codemicro/macropad/.github/README.md

# Macropad

A project to create a custom macropad based on the Raspberry Pi Pico, including custom hardware and software design.

## Links

* Raspberry Pi Pico Eagle CAD library - [codemicro/pico-eagle](https://github.com/codemicro/pico-eagle)
* Cherry MX keyswitche Eagle CAD library - [c0z3n/cherrymx-eagle](https://github.com/c0z3n/cherrymx-eagle)

## rev0

| **Board scan** | **Assembled** | **Schematic** |
| --- | --- | --- |
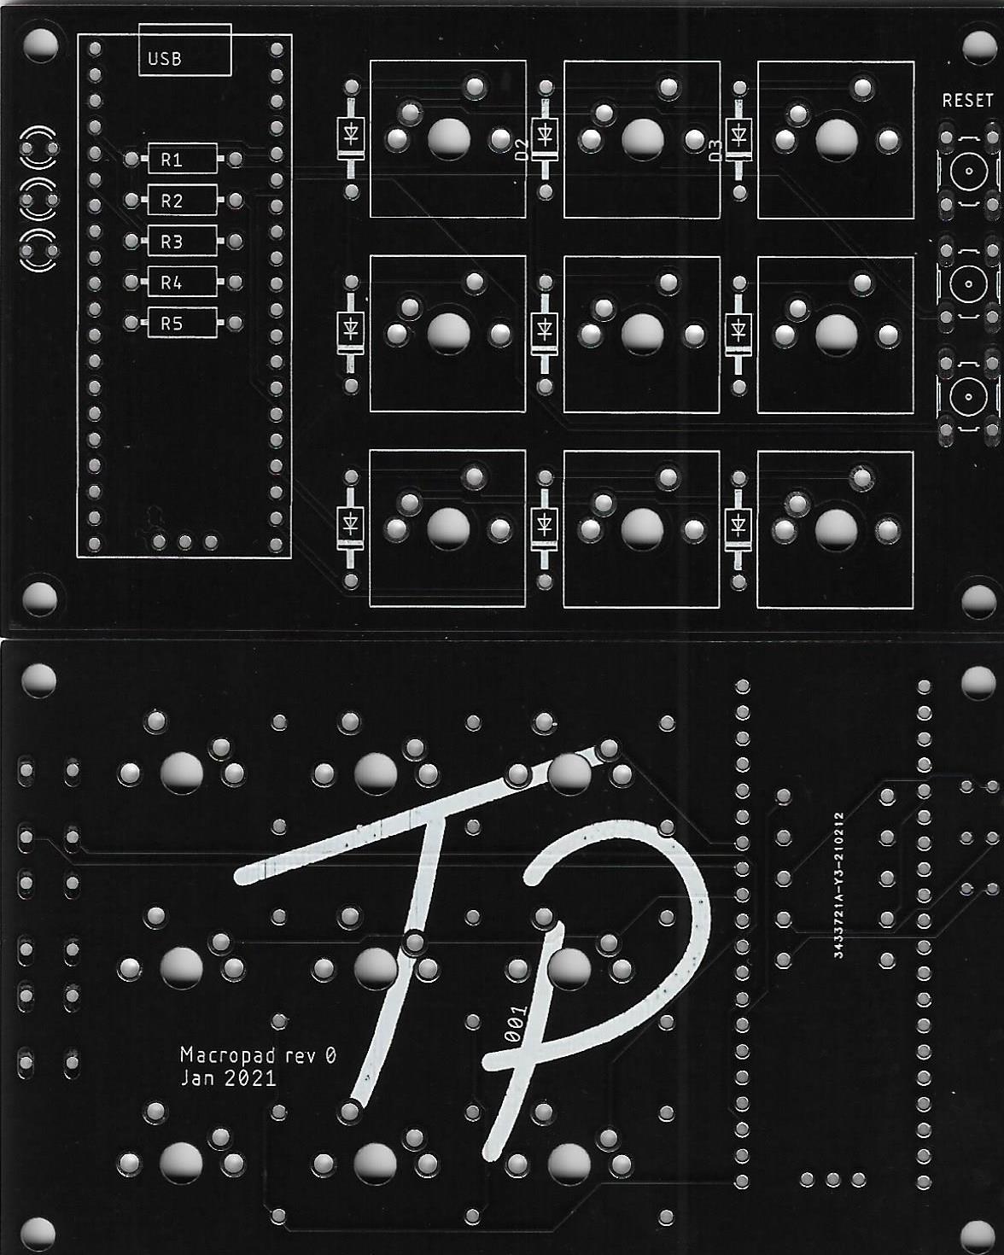
[picture p1: .github/images/rev0scan.jpg]
rev0 board scan
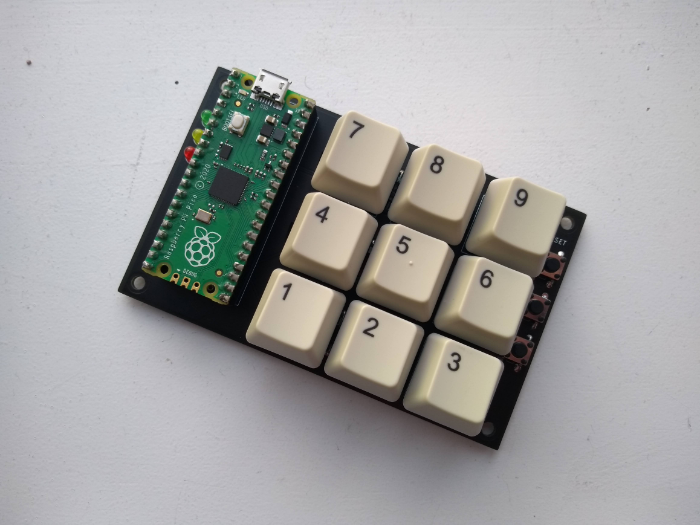
[picture p2: .github/images/rev0.png]
rev0 assembled
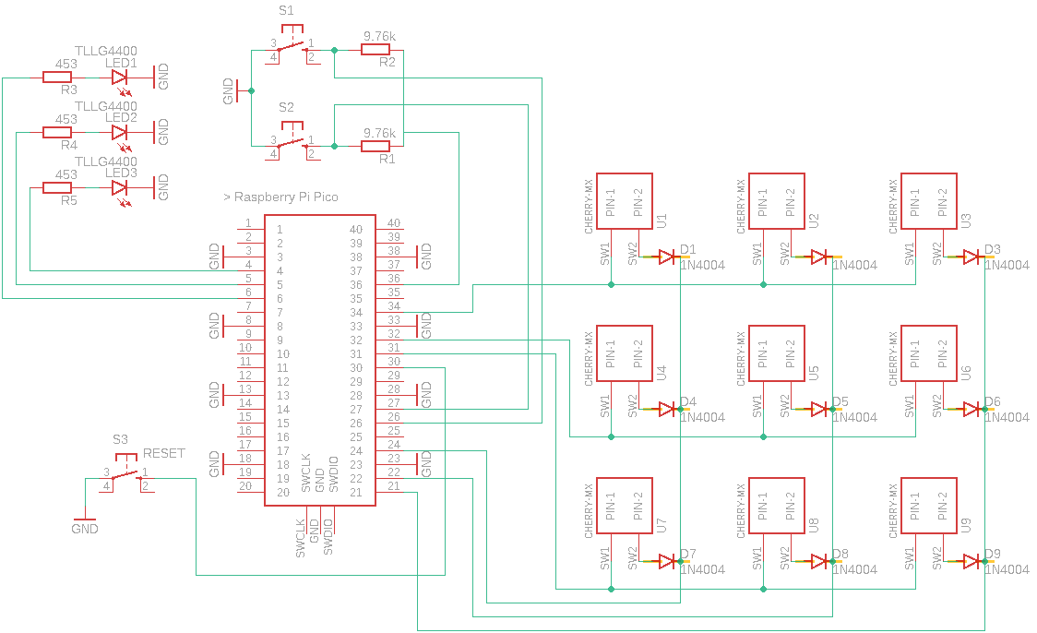
[picture p3: .github/images/rev0schem.png]
rev0 schematic
|  |  |  |

Functionally perfect, ideal LED position would be below the Pi Pico and not alongside it, however.

### Improvements

* Option for a small OLED I2C OLED display (like [this 0.96" one](https://www.amazon.co.uk/MakerHawk-Display-Module-128X64-Arduino/dp/B0777HHQDT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))
* Hotswap keyswitch sockets
* Multiple PCB layers, so the Pico or other microcontroller can be sandwiched inbetween
* Perhaps a different microcontroller, like the Pro Micro?
  * The Pico is more affordable than a genuine Pro Micro but [this thing](https://www.sparkfun.com/products/15795) does look super cool
* Pico SMD support using castellations instead of header pins
  * Maybe options for both on the same board?
* More/RGB LEDs
* Silkscreen had leftover component labels that I *thought* I'd properly removed (D2, D3)
