codemicro/macropad/design/rev0/README.txt

The following options were used when ordering these PCBs from JLCPCB. Take special note of "remove order number" - the text "JLCJLCJLCJLC" is present on the underside of the board to facilitate this.

Layers: 2
Dimension: 100*62mm
Delivery Fomat: Single PCB
PCB Thickness: 1.6mm
Copper Weight: 1oz
Gold Fingers: No
Castellated Holes: No
Remove Order Number: Specify a location

PCB Color: Black
Surface Finish: HASL (with lead)
