codemicro/macropad/design/rev0/rev0.brd.pdf

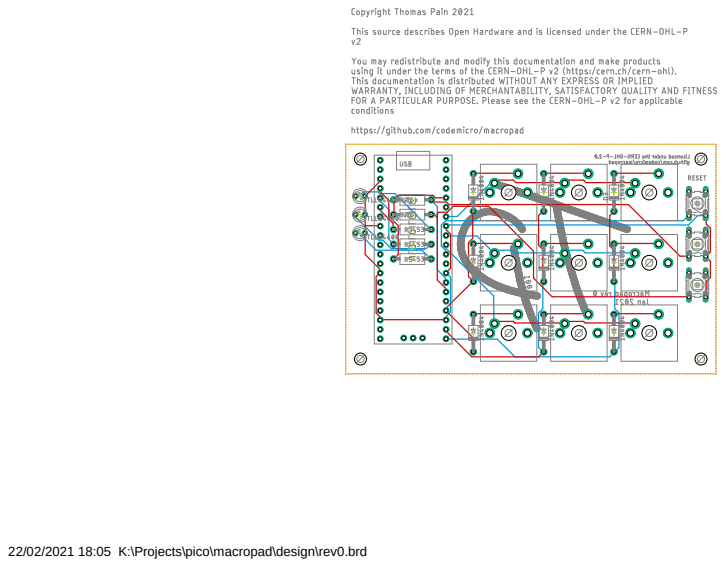
[picture p4: page 1]

22/02/2021 18:05 K:\Projects\pico\macropad\design\rev0.brd
