codemicro/macropad/design/rev0/rev0.sch.pdf

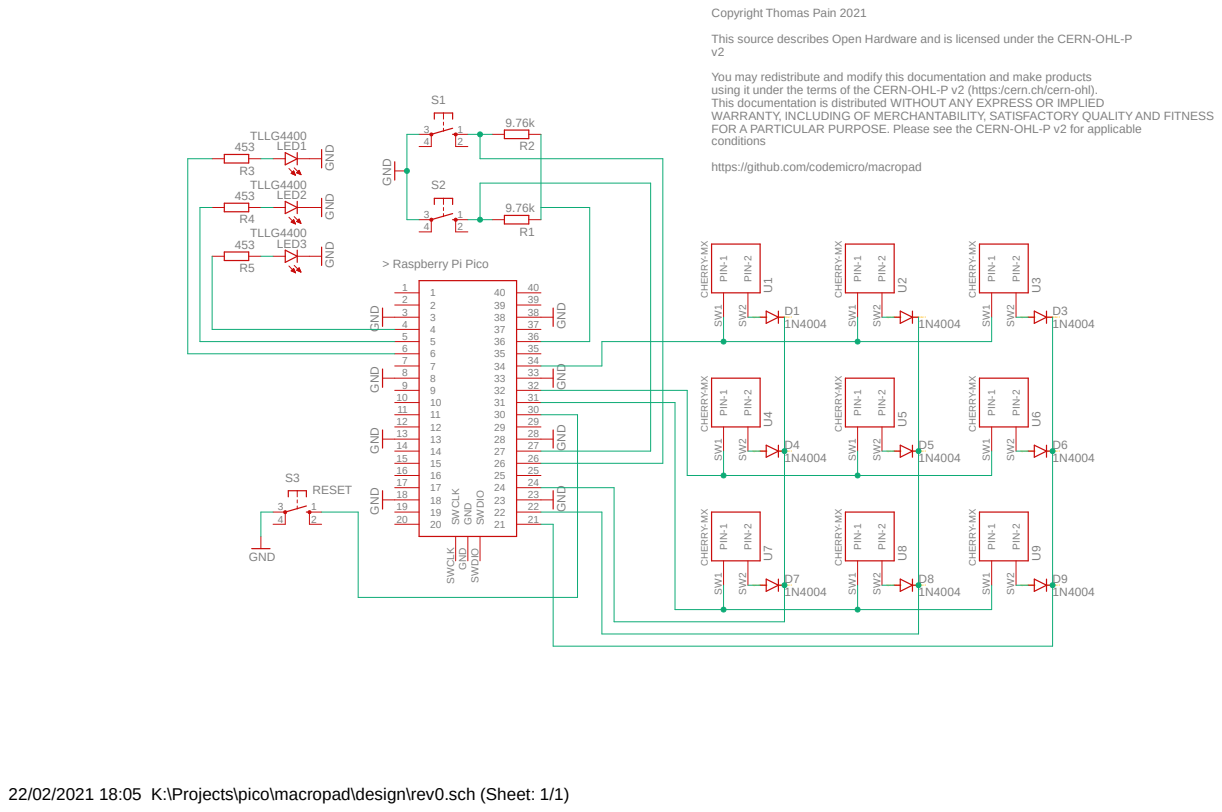
[picture p5: page 1]

Copyright Thomas Pain 2021
This source describes Open Hardware and is licensed under the CERN-OHL-P
You may redistribute and modify this documentation and make products
using it under the terms of the CERN-OHL-P v2 (https:/cern.ch/cern-ohl).
This documentation is distributed WITHOUT ANY EXPRESS OR IMPLIED
WARRANTY, INCLUDING OF MERCHANTABILITY, SATISFACTORY QUALITY AND FITNESS
FOR A PARTICULAR PURPOSE. Please see the CERN-OHL-P v2 for applicable
conditions
https://github.com/codemicro/macropad

22/02/2021 18:05 K:\Projects\pico\macropad\design\rev0.sch (Sheet: 1/1)
