codemicro/macropad/design/rev0/rev0.brd

## EAGLE design design/rev0/rev0.brd (2021-02-22, an earlier design)

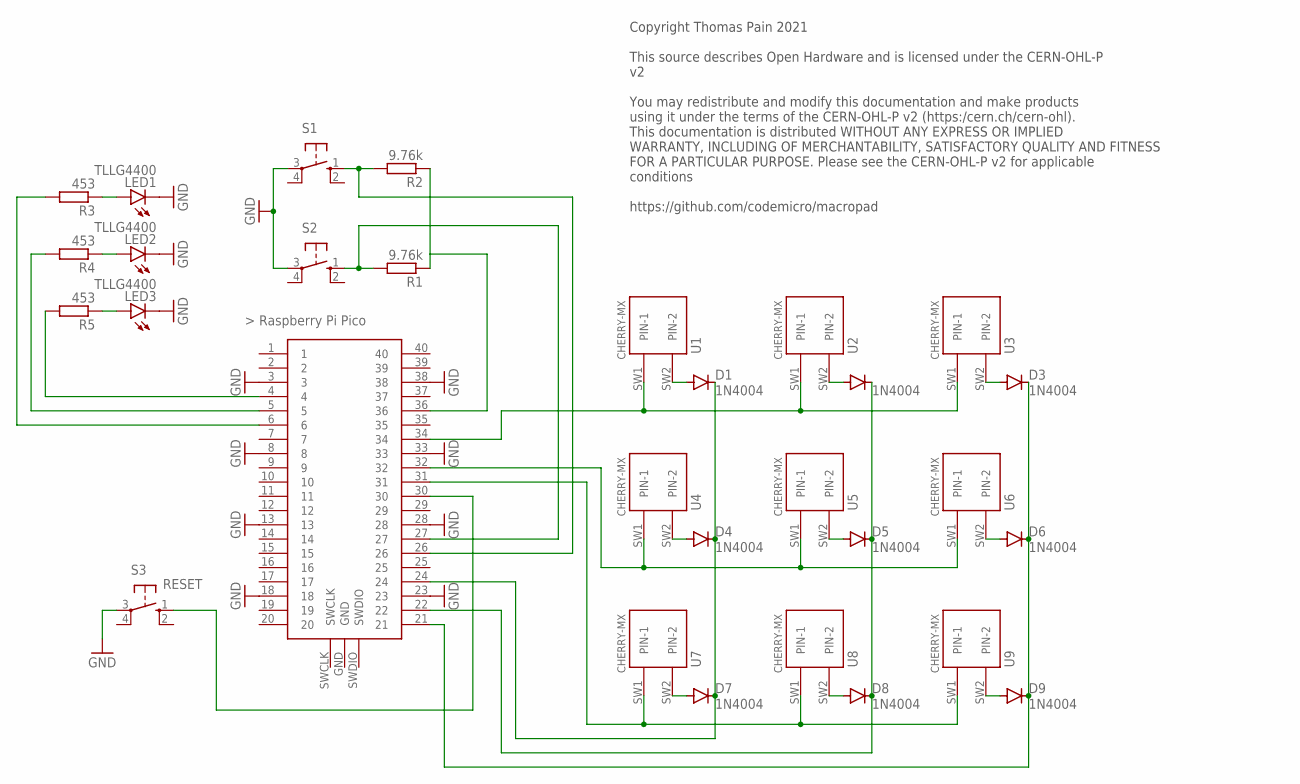
[picture p6: schematic rev0.sch]

Parts:
D1, D2, D3, D4, D5, D6, D7, D8, D9: 1N4004; DO41-10
LED1, LED2, LED3: TLLG4400; LED3MM
R1, R2: 9.76k; VMTA55
R3, R4, R5: 453; VMTA55
S1, S2: 10-XX; B3F-10XX
S3: RESET; B3F-10XX
U1, U2, U3, U4, U5, U6, U7, U8, U9: CHERRY-MX
U$1: RASPBERRY-PI-PICO_TH; FT_RASPBERRY-PI-PICO_TH

Connections:
GND: LED1.K (C), LED2.K (C), LED3.K (C), S1.3, S2.3, S3.3, U$1.3, U$1.8, U$1.13, U$1.18, U$1.23, U$1.28, U$1.33, U$1.38
unnamed: LED2.A, R4.1
unnamed: LED1.A, R3.1
unnamed: LED3.A, R5.1
unnamed: R1.2, S2.1 (S), U$1.27
unnamed: R5.2, U$1.4
unnamed: R4.2, U$1.5
unnamed: R3.2, U$1.6
unnamed: R2.2, S1.1 (S), U$1.26
unnamed: R1.1, R2.1, U$1.36
unnamed: S3.1 (S), U$1.30
unnamed: D1.C, D4.C, D7.C, U$1.24
unnamed: D2.C, D5.C, D8.C, U$1.22
unnamed: D3.C, D6.C, D9.C, U$1.21
unnamed: D6.A, U6.SW2 (PIN-2)
unnamed: D3.A, U3.SW2 (PIN-2)
unnamed: D9.A, U9.SW2 (PIN-2)
unnamed: D8.A, U8.SW2 (PIN-2)
unnamed: D5.A, U5.SW2 (PIN-2)
unnamed: D2.A, U2.SW2 (PIN-2)
unnamed: D1.A, U1.SW2 (PIN-2)
unnamed: D4.A, U4.SW2 (PIN-2)
unnamed: D7.A, U7.SW2 (PIN-2)
unnamed: U1.SW1 (PIN-1), U2.SW1 (PIN-1), U3.SW1 (PIN-1), U$1.34
unnamed: U4.SW1 (PIN-1), U5.SW1 (PIN-1), U6.SW1 (PIN-1), U$1.32
unnamed: U7.SW1 (PIN-1), U8.SW1 (PIN-1), U9.SW1 (PIN-1), U$1.31

Notes on the sheet:
Copyright Thomas Pain 2021 This source describes Open Hardware and is licensed under the CERN-OHL-P v2 You may redistribute and modify this documentation and make products using it under the terms of the CERN-OHL-P v2 (https:/cern.ch/cern-ohl). This documentation is distributed WITHOUT ANY EXPRESS 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

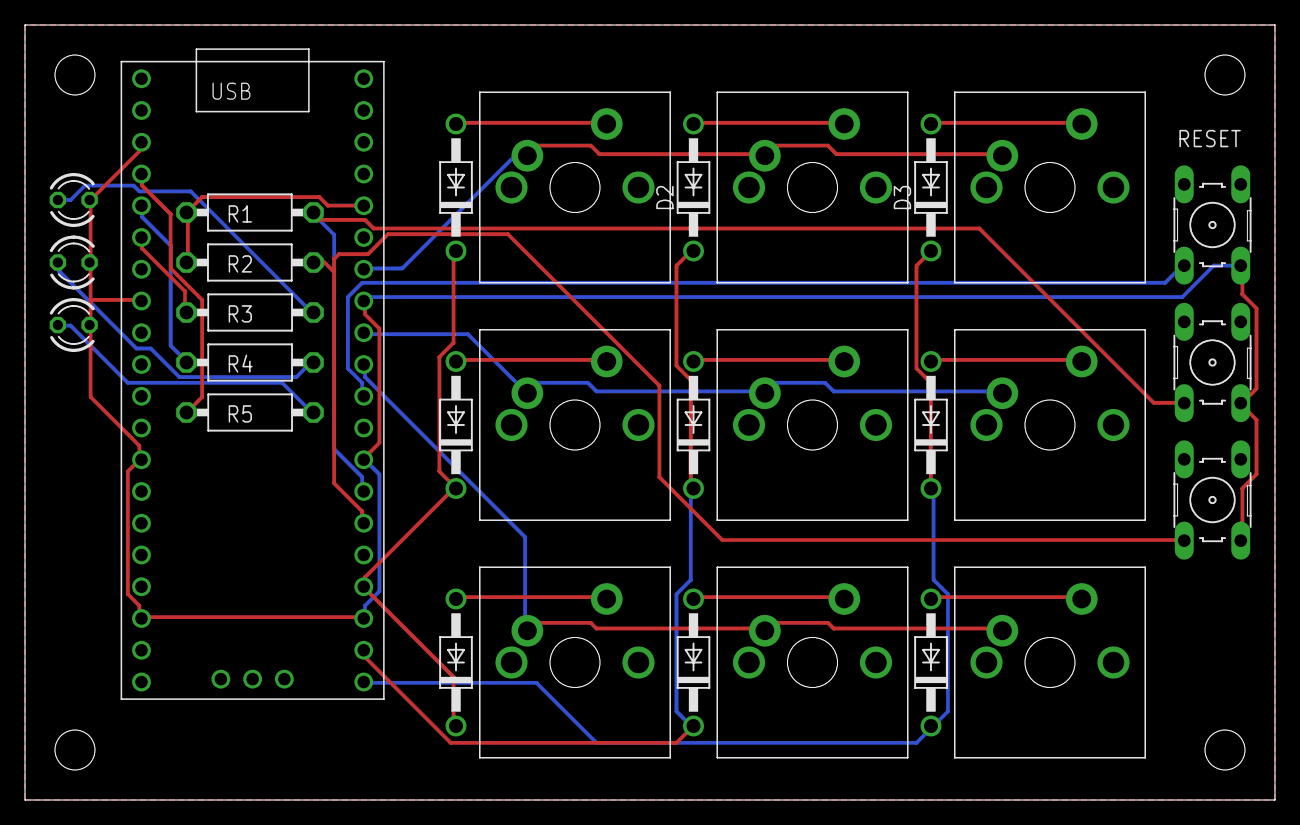
[picture p7: board rev0.brd from above]

Board: 2 copper layers, 100.0 x 62.0 mm, 30 parts (0 on the bottom side), 26 nets.
