codemicro/macropad/(commit log)

2021-01-31 Switch to CircuitPython, add bundler.json for dependencies
2021-01-31 Switch to using GP13 tied high
2021-01-31 Add current schematic
2021-02-01 Add Eagle schematic
    [v0.sch]
2021-02-02 Add Cherry MX Eagle CAD library to README.md
2021-02-02 Update schematic
    [v0.sch]
2021-02-05 Fix resistor locations on buttons
    [v0.sch]
2021-02-05 Update LED resistor values
    [v0.sch]
2021-02-05 Add initial prototype page
2021-02-05 Switch keyswitches
2021-02-06 Switched component pins, added ground plane
    [v0.sch]
2021-02-06 Added board design
    [v0.brd]
2021-02-07 Update net class width, swap R1/R2 names
    [v0.sch]
2021-02-07 Add silkscreen text, move labels, perform routing
    [v0.brd]
2021-02-07 Update .gitignore for Eagle CAD files
2021-02-11 Add missing ground marker
    [v0.sch]
2021-02-11 Silkscreen tweaks
    [v0.brd]
2021-02-11 Remove useless silkscreen labels
    [v0.brd]
2021-02-11 Move trace that was kinda close to a pad
    [v0.brd]
2021-02-20 Add rev0 board test
2021-02-21 Rename v0.* -> rev0.*
    [rev0.brd, rev0.sch]
2021-02-21 Add scans of rev0 boards
2021-02-22 Remove prototype docs
2021-02-22 Add licencing
    [rev0.brd, rev0.sch]
2021-02-25 Add rev0 specification
    [rev0.brd, rev0.sch]
