codemicro/macropad/(notices)

Notices in the files:
design/rev0/rev0.brd:
Licenced under the CERN-OHL-P-2.0
